Danielskauge/report-project-thesis/Images/results/grid_search_mars_results.png

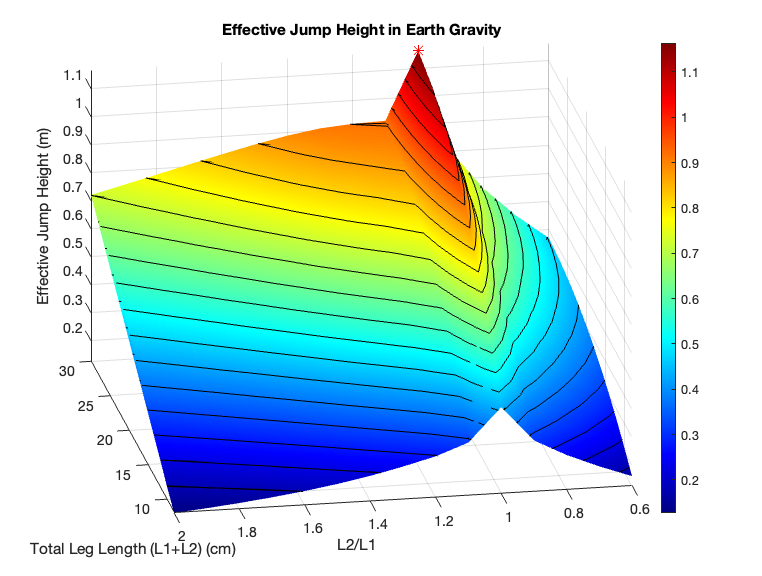
Images/results/grid_search_mars_results.png
