Danielskauge/report-project-thesis/Sections/Abbreviations.tex

\section*{Abbreviations}

\begin{longtable}[l]{p{0.2\textwidth} p{0.75\textwidth}}
    \textbf{Abbreviation} & \textbf{Description} \\
    \hline
    
    \textbf{DRL} & Deep Reinforcement Learning \\
    \textbf{BLDC} & Brushless DC \\
    \textbf{DOF} & Degrees of Freedom \\
    \textbf{CAD} & Computer-Aided Design \\
    \textbf{CNC} & Computer Numerical Control \\
    \textbf{MCU} & Microcontroller Unit \\
    \textbf{MSE} & Mean Squared Error \\
    \textbf{PWM} & Pulse Width Modulation \\
    \textbf{I2C} & Inter-Integrated Circuit \\
    \textbf{ADC} & Analog-to-Digital Converter \\
    \hline
\end{longtable}

\clearpage
