Danielskauge/report-project-thesis/Sections/title.tex

% Inspired by title template from ShareLaTeX Learn; Gubert Farnsworth & John Doe
% Edited by Jon Arnt Kårstad, NTNU IMT

\begin{titlepage}
\vbox{ }
\vbox{ }
\begin{center}
% Upper part of the page
\\[1cm]
\textsc{\LARGE Department of Engineering Cybernetics}\\[1.5cm]
\textsc{\Large TTK4550 - Specialization Project}\\[0.5cm]
\vbox{ }

% Title
\HRule \\[0.4cm]
{ \huge \bfseries Design and Control of a Spring-actuated Jumping Quadruped in Earth Gravity}\\[0.4cm]
\HRule \\[1.5cm]

% Author
\large
\emph{Author:}\\
Johannes Ihle\\
Daniel Rosmæl Skauge\\
\vspace{1em}
\emph{Supervisor:}\\
Prof. Dr. Kostas Alexis\\
\vspace{1em}
\emph{Co-supervisor:}\\
Jørgen Anker Olsen
\vfill

% Bottom of the page
{\large Date: \today}
\end{center}
\end{titlepage}
