Danielskauge/report-project-thesis/Sections/Design.pdf

??????θ1 =

−

(θ2+π)
2
˙θ2 =
−2

˙θ1
??θ2
????????

manipulator.pngT hemanipulatorcorrespondingtoaverticalonelegjump.

xend = L1 cos(θ1)+L2 cos(θ1+θ2)yend = L1 sin(θ1)+L2 sin(θ1+θ2)
(1)
1 sin(θ1)−
L2 sin(θ1+
θ2)−
L2 sin(θ1+
θ2)
L1 cos(θ1)+
L2 cos(θ1+
θ2)L2 cos(θ1+
θ2)
jacobianvelocity.epsV erticalP awvelocityasafunctionof kneeangle.
????????

## Robot Jumping Controller Logic

Friction Scaling:
Nµ ← 0.8 Nµ

Angle Conversions (Degrees to Radians):

θ1 =

π
180
θhip deg, | θ2 = π
| 180 θknee deg

w1 =

π
180
whip deg, | w2 = π
| 180 wknee deg

Link Lengths:
l1 = thigh l m, l2 = calf l m

Capping Angular Velocities:

w1,abs = min(|w1|, whip max), w2,abs = min(|w2|, wknee max)

Maximum Torque Based on Speed:

τ1,max abs = τhip stall
1 −
| w1,abs

whip max

τ2,max abs = τknee stall
1 −

w2,abs

wknee max

Assigning Torques:

τ2 = τ2,max abs, τ1,motor dyn limit = −τ1,max abs

Friction Cone Constraint:

τ1,friction cone limit =

− l1 l2 sin(θ2) Nµ +

l1 sin(θ1) + l2 sin(θ1 + θ2)
τ2
l2 sin(θ1 + θ2)

Final Hip Torque Selection:

τ1 = max

τ1,motor dyn limit, τ1,friction cone limit

Direction-Dependent Torque Output:

τhip = (front1 backneg1) τ1, τknee = (front1 backneg1) τ2

2
