Danielskauge/report-project-thesis/Images/vertical_paw_velocity-eps-converted-to.pdf

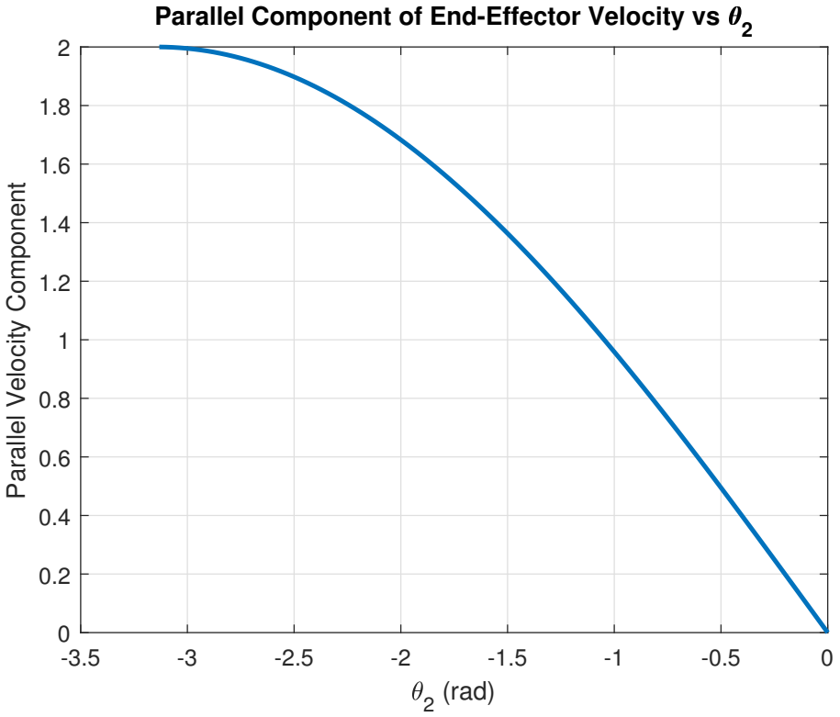
[picture p34: figure]
(rad); Parallel Velocity Component

Parallel Component of End-Effector Velocity vs 2
