Danielskauge/report-project-thesis/Images/horizontal_jacobian_velocity-eps-converted-to.pdf

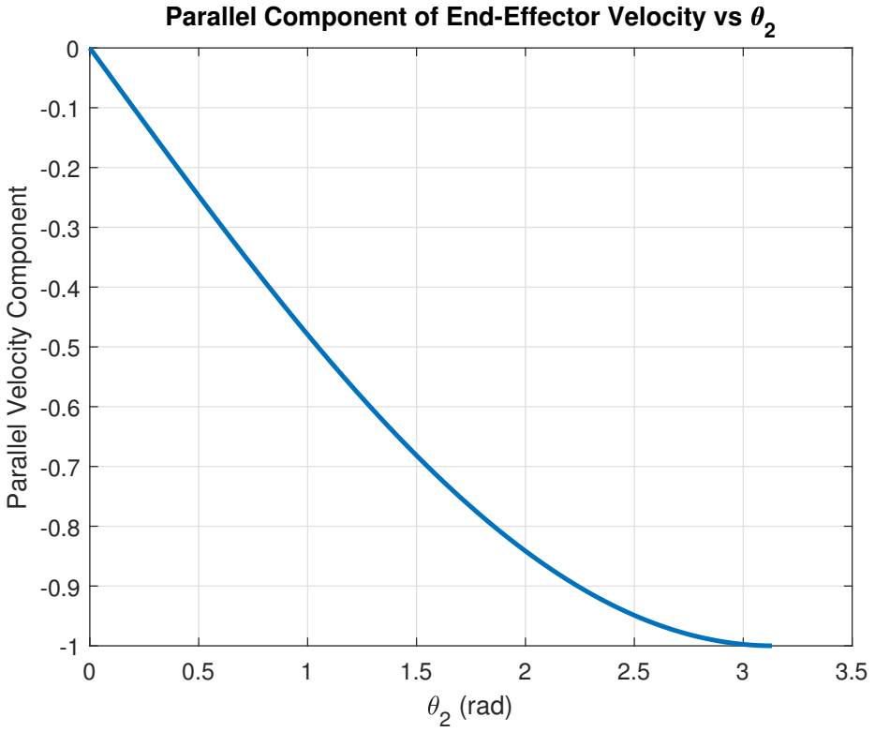
[picture p35: figure]
(rad); Parallel Velocity Component

Parallel Component of End-Effector Velocity vs 2
