Danielskauge/report-project-thesis/Images/joint_speed_A80-eps-converted-to.pdf

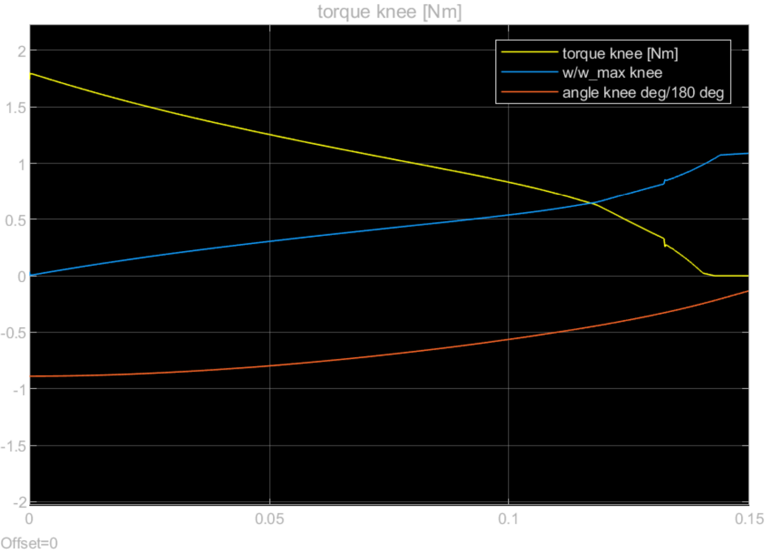
[picture p36: page 1]
