Danielskauge/report-project-thesis/Images/hip_motor_torque-eps-converted-to.pdf

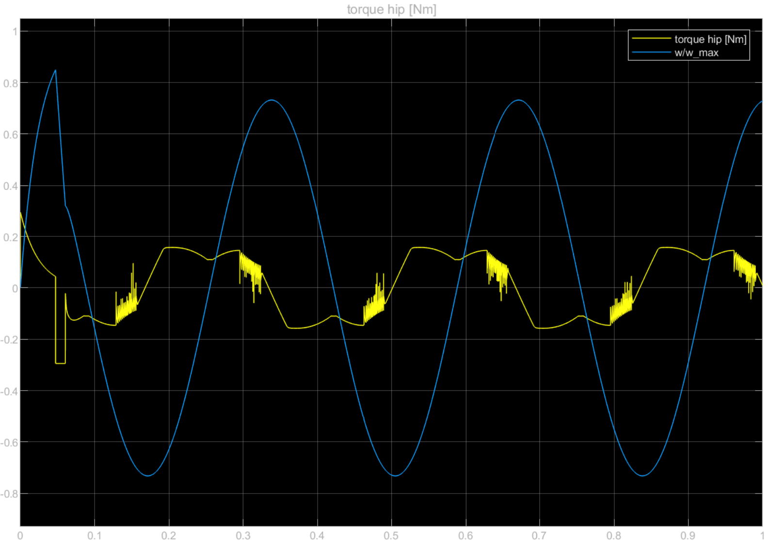
[picture p37: page 1]
