Danielskauge/report-project-thesis/Images/A06_motor_info.jpg

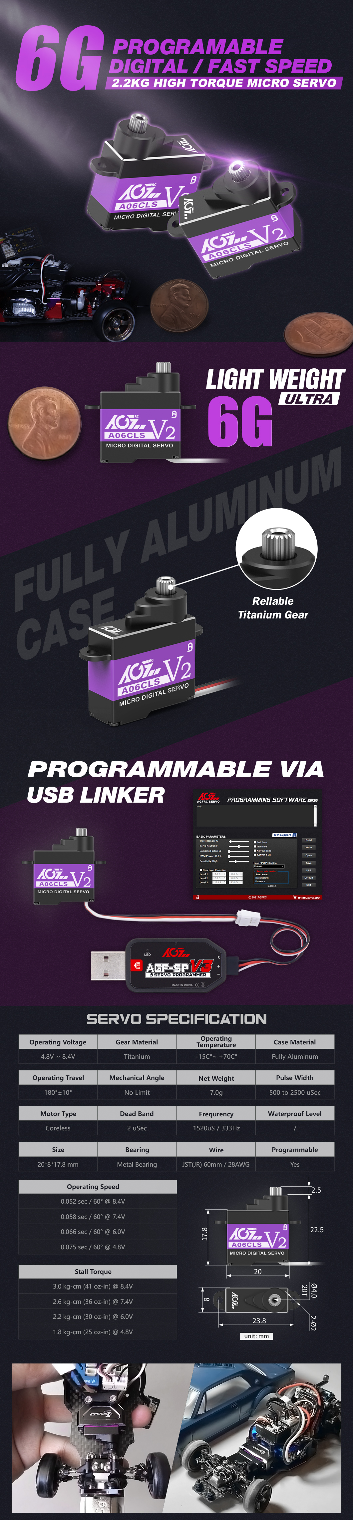
Images/A06_motor_info.jpg
