Danielskauge/report-project-thesis/Images/angle_conventions.png

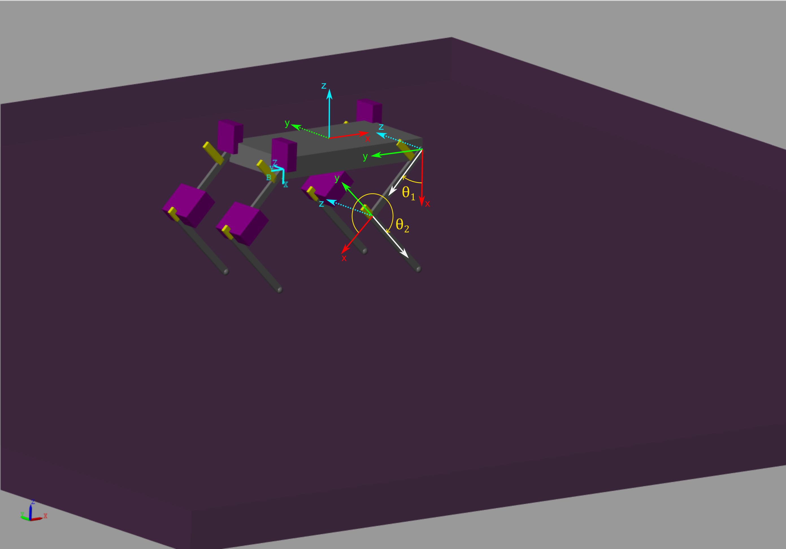
Images/angle_conventions.png
