Danielskauge/report-project-thesis/Images/attituding_hips.png

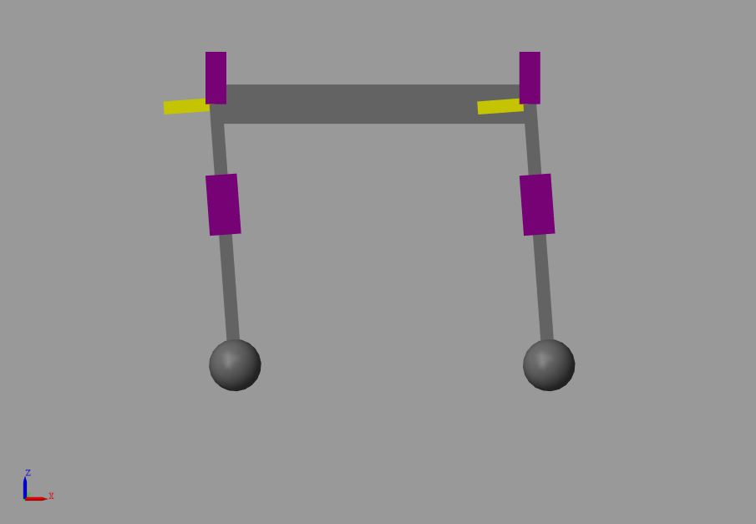
Images/attituding_hips.png
