Danielskauge/report-project-thesis/Images/CAD_leg_exploded_annotate.png

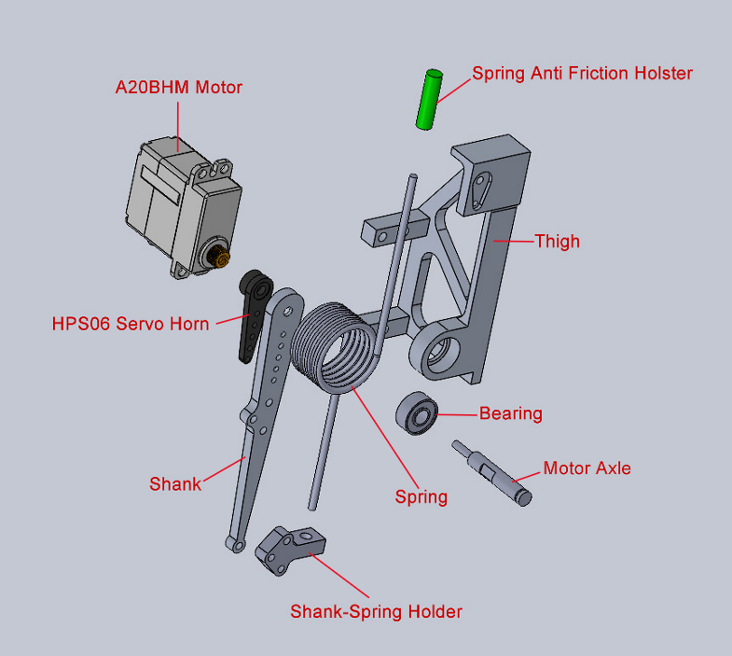
Images/CAD_leg_exploded_annotate.png
