Danielskauge/report-project-thesis/Images/crouched_simscape_robot.png

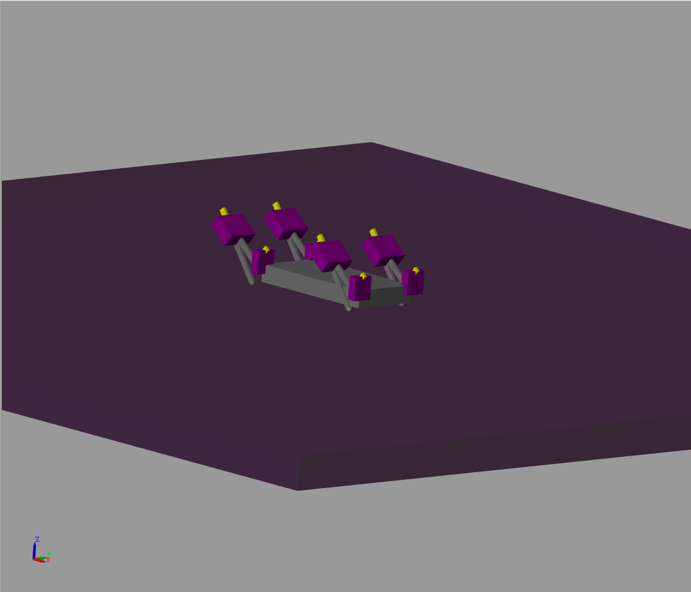
Images/crouched_simscape_robot.png
