Danielskauge/report-project-thesis/Images/DOF2_w_extension_spring.png

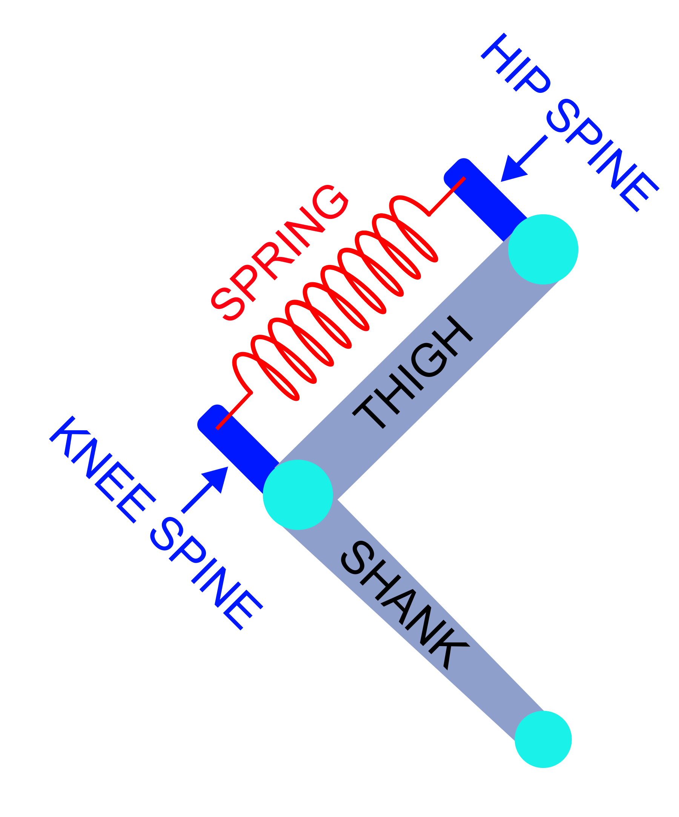
Images/DOF2_w_extension_spring.png
