Danielskauge/report-project-thesis/Images/exploded_motor_holder_hip.png

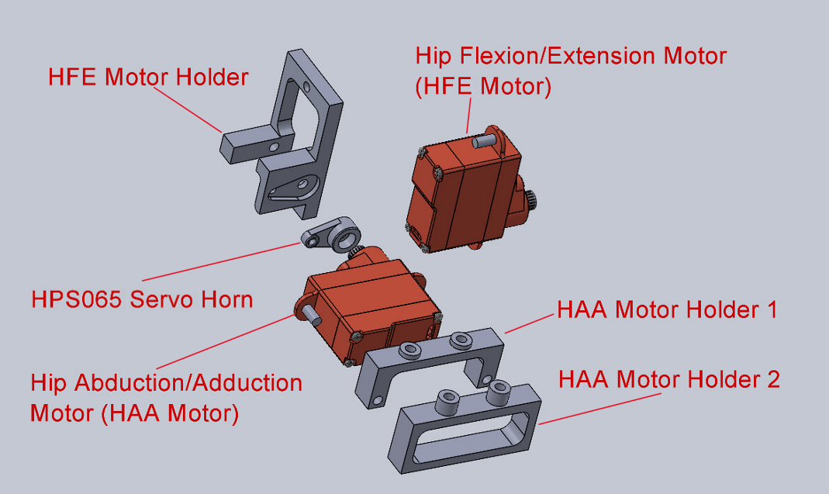
Images/exploded_motor_holder_hip.png
