Danielskauge/report-project-thesis/Images/extension_spring.png

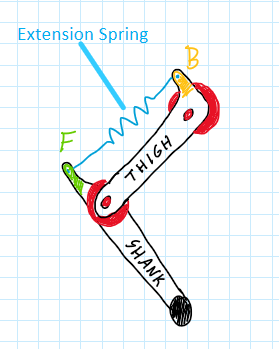
Images/extension_spring.png
