Danielskauge/report-project-thesis/Images/friction_estimation/big_motor.jpg

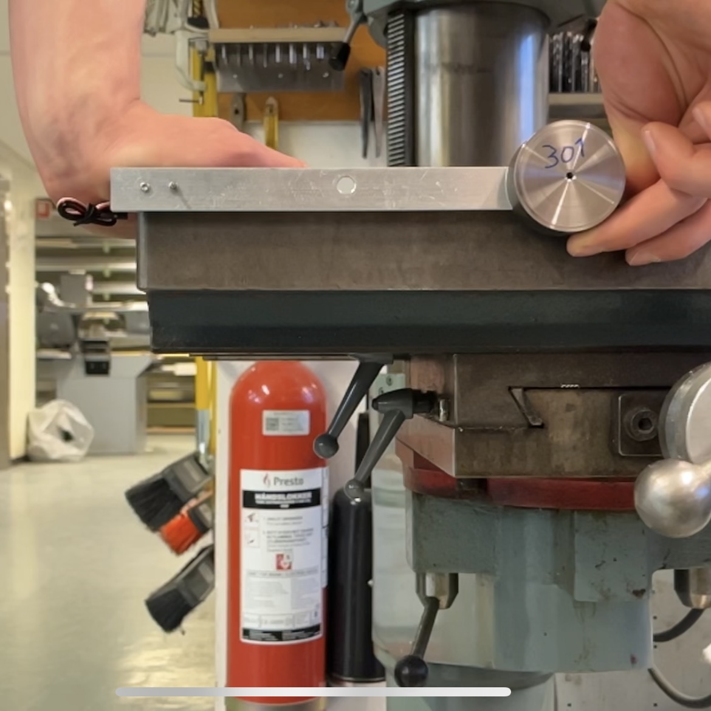
Images/friction_estimation/big_motor.jpg
