Danielskauge/report-project-thesis/Images/friction_estimation/pendulum_sim_hip.png

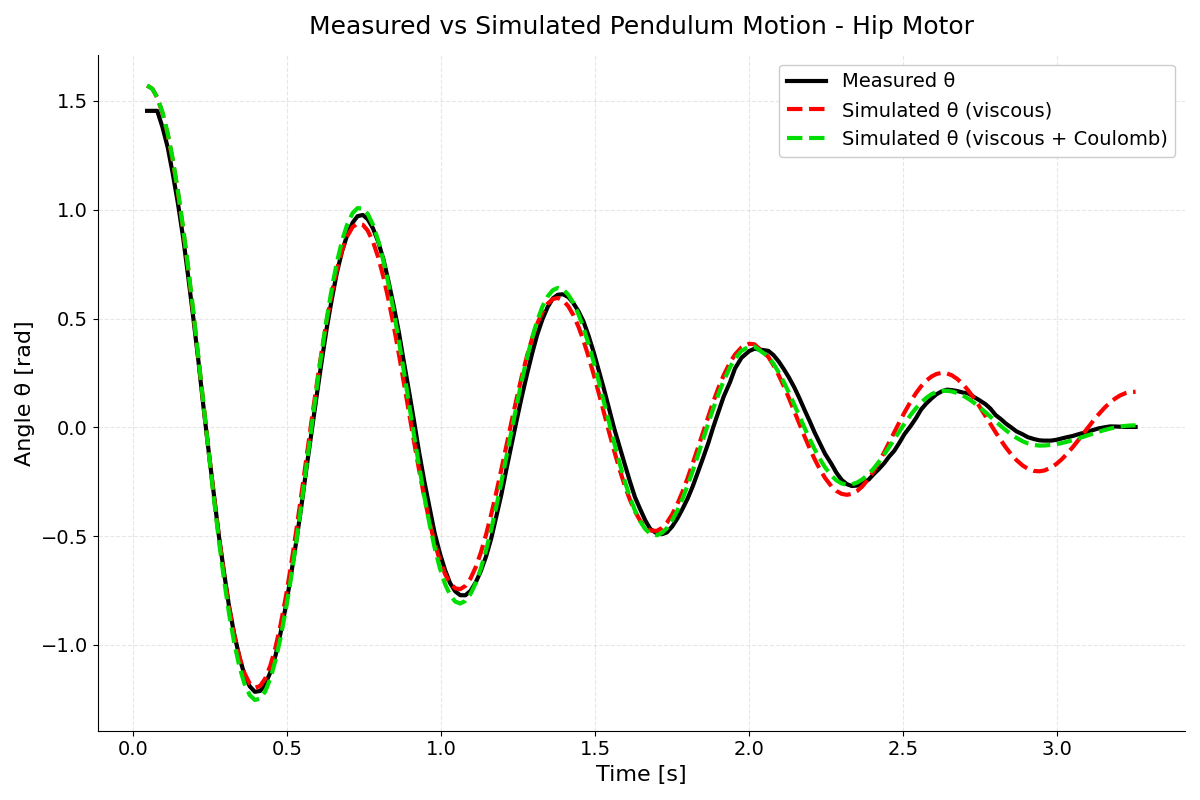
Images/friction_estimation/pendulum_sim_hip.png
