Danielskauge/report-project-thesis/Images/friction_estimation/pendulum_sim_knee.png

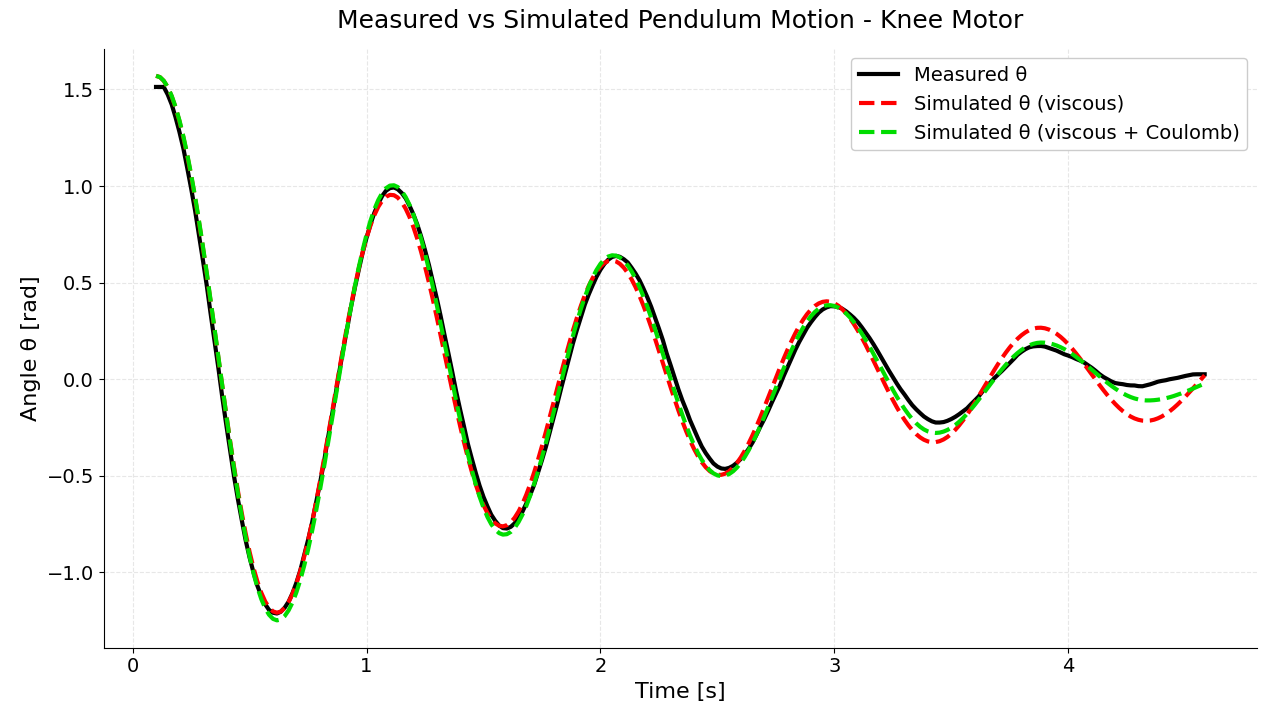
Images/friction_estimation/pendulum_sim_knee.png
