Danielskauge/report-project-thesis/Images/friction_estimation/small_motor.jpg

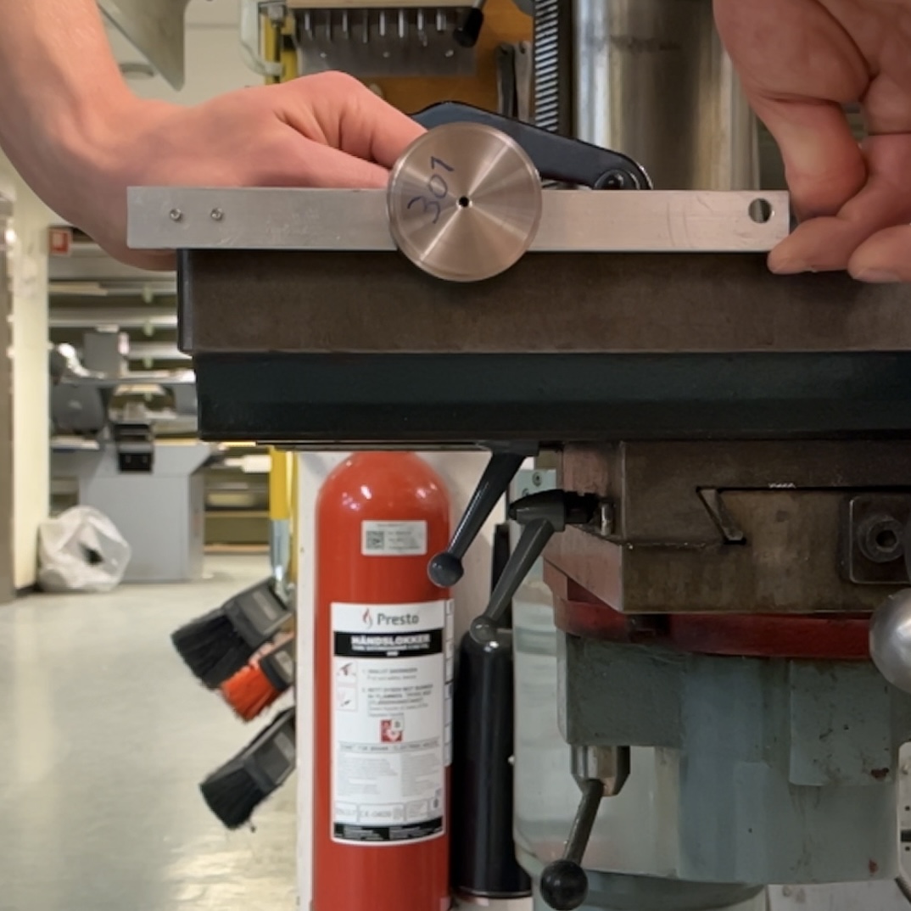
Images/friction_estimation/small_motor.jpg
