Danielskauge/report-project-thesis/Images/hip_motor_in_housing.JPG

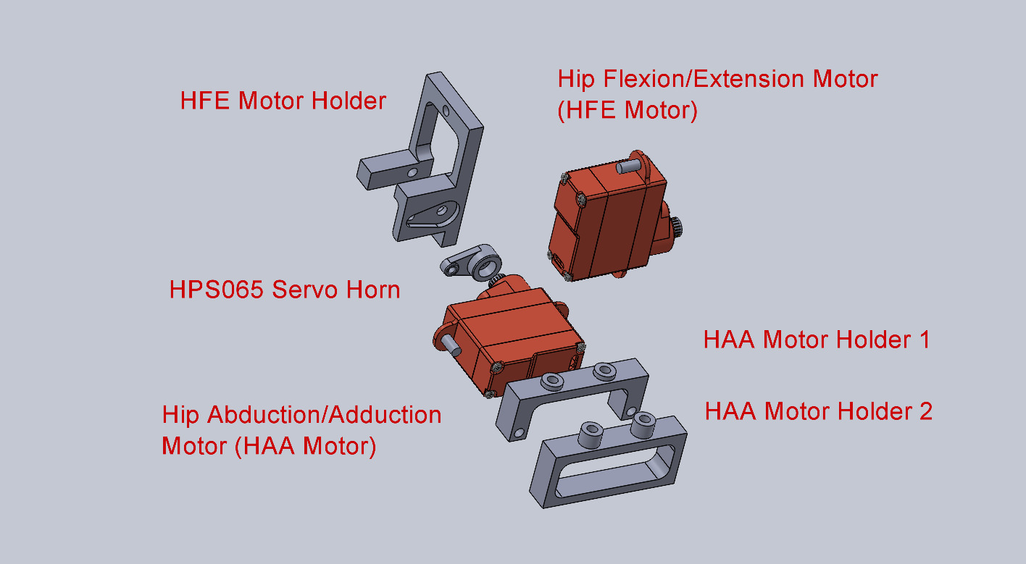
Images/hip_motor_in_housing.JPG
