Danielskauge/report-project-thesis/Images/legv3_annotated.SLDASM.JPG

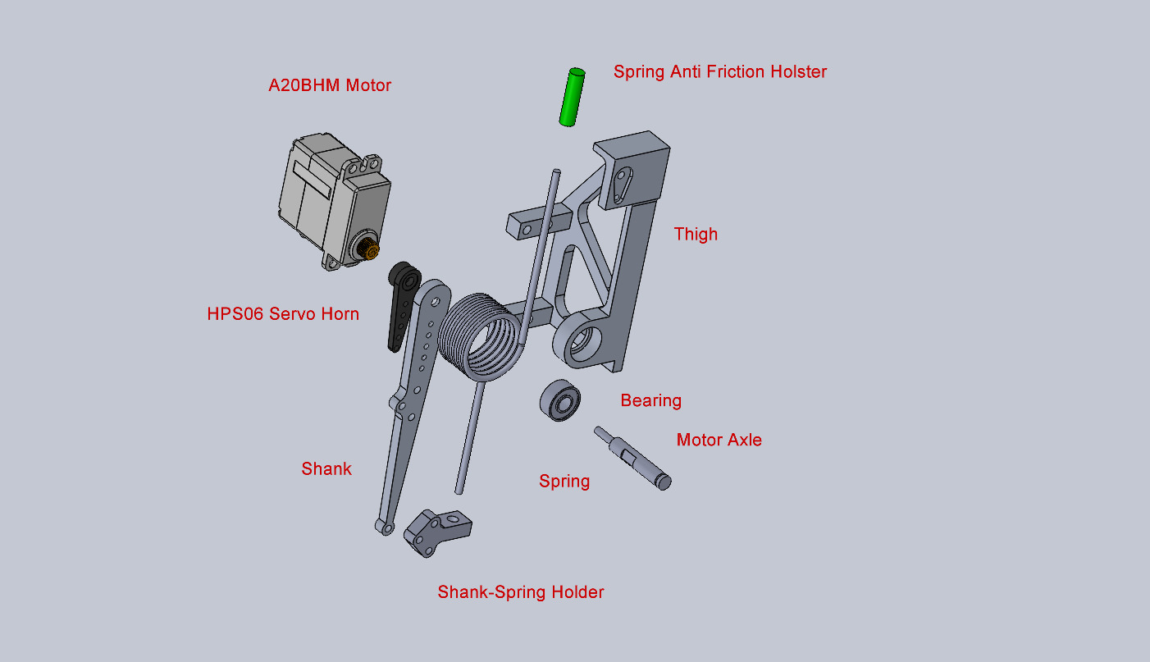
Images/legv3_annotated.SLDASM.JPG
