Danielskauge/report-project-thesis/Images/legv3_exploeded.JPG

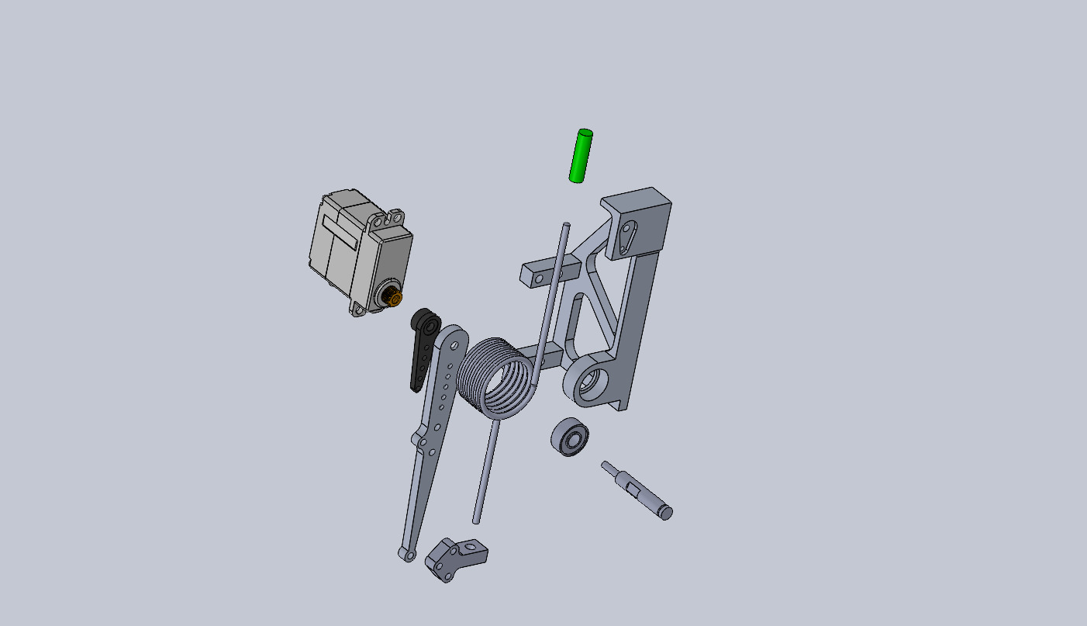
Images/legv3_exploeded.JPG
