Danielskauge/report-project-thesis/Images/link_length_optimization/adjusted_paw_pose.png

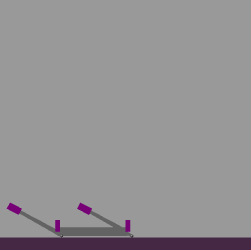
Images/link_length_optimization/adjusted_paw_pose.png
