Danielskauge/report-project-thesis/Images/link_length_optimization/longer_L1_pose.png

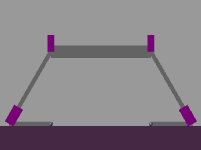
Images/link_length_optimization/longer_L1_pose.png
