Danielskauge/report-project-thesis/Images/link_length_optimization/symmetric_unadjusted_paws.png

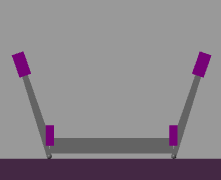
Images/link_length_optimization/symmetric_unadjusted_paws.png
