Danielskauge/report-project-thesis/Images/manipulator_inkscape.png

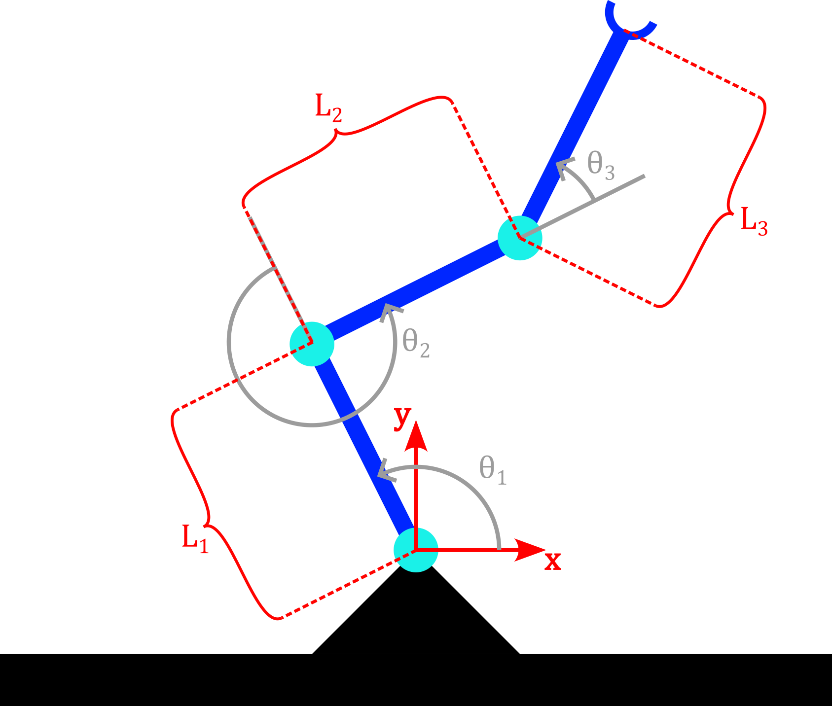
Images/manipulator_inkscape.png
