Danielskauge/report-project-thesis/Images/motor_model_function.png

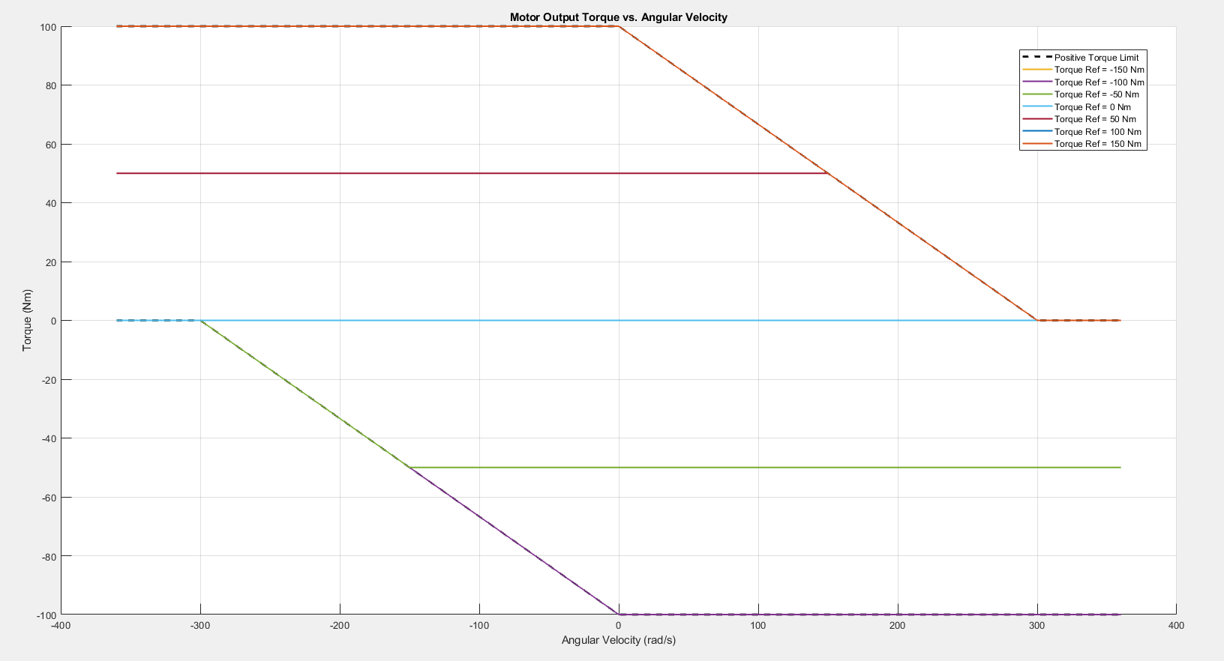
Images/motor_model_function.png
