Danielskauge/report-project-thesis/Images/naming_conventions.png

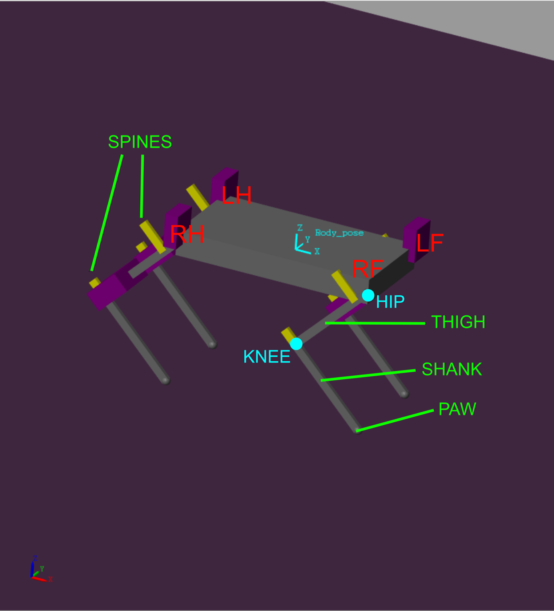
Images/naming_conventions.png
