Danielskauge/report-project-thesis/Images/one_axis_jump.png

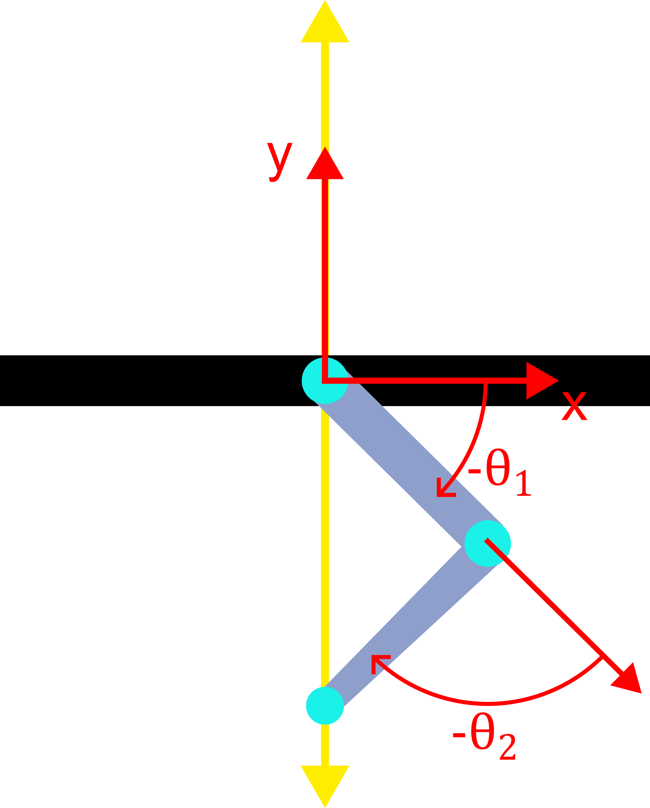
Images/one_axis_jump.png
