Danielskauge/report-project-thesis/Images/parallell_spring_inkscape.png

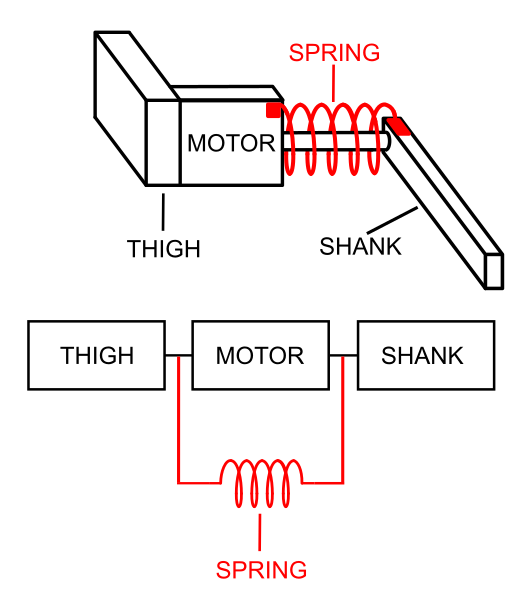
Images/parallell_spring_inkscape.png
