Danielskauge/report-project-thesis/Images/Screenshot 2024-12-17 at 19.40.37.png

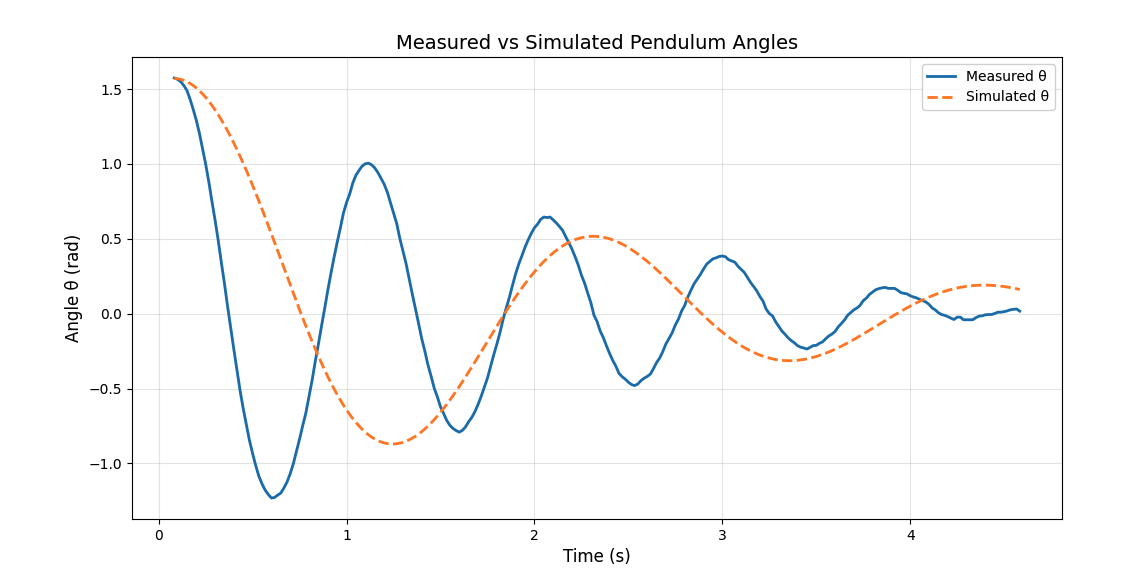
Images/Screenshot 2024-12-17 at 19.40.37.png
