Danielskauge/report-project-thesis/Images/series_elastic_inkscape.png

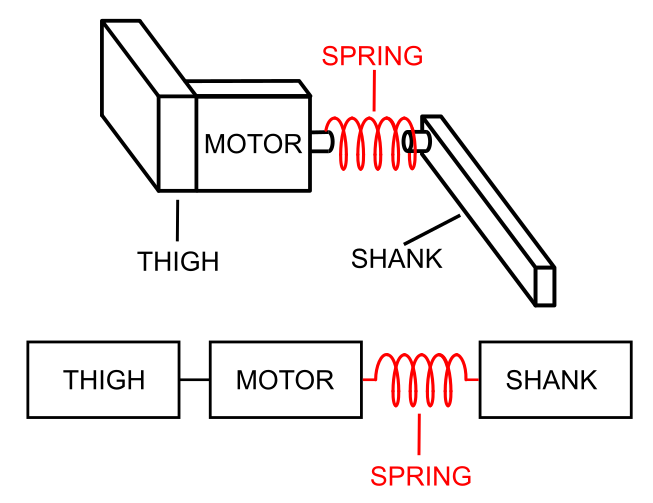
Images/series_elastic_inkscape.png
