Danielskauge/report-project-thesis/Images/simcape_extension_spring.png

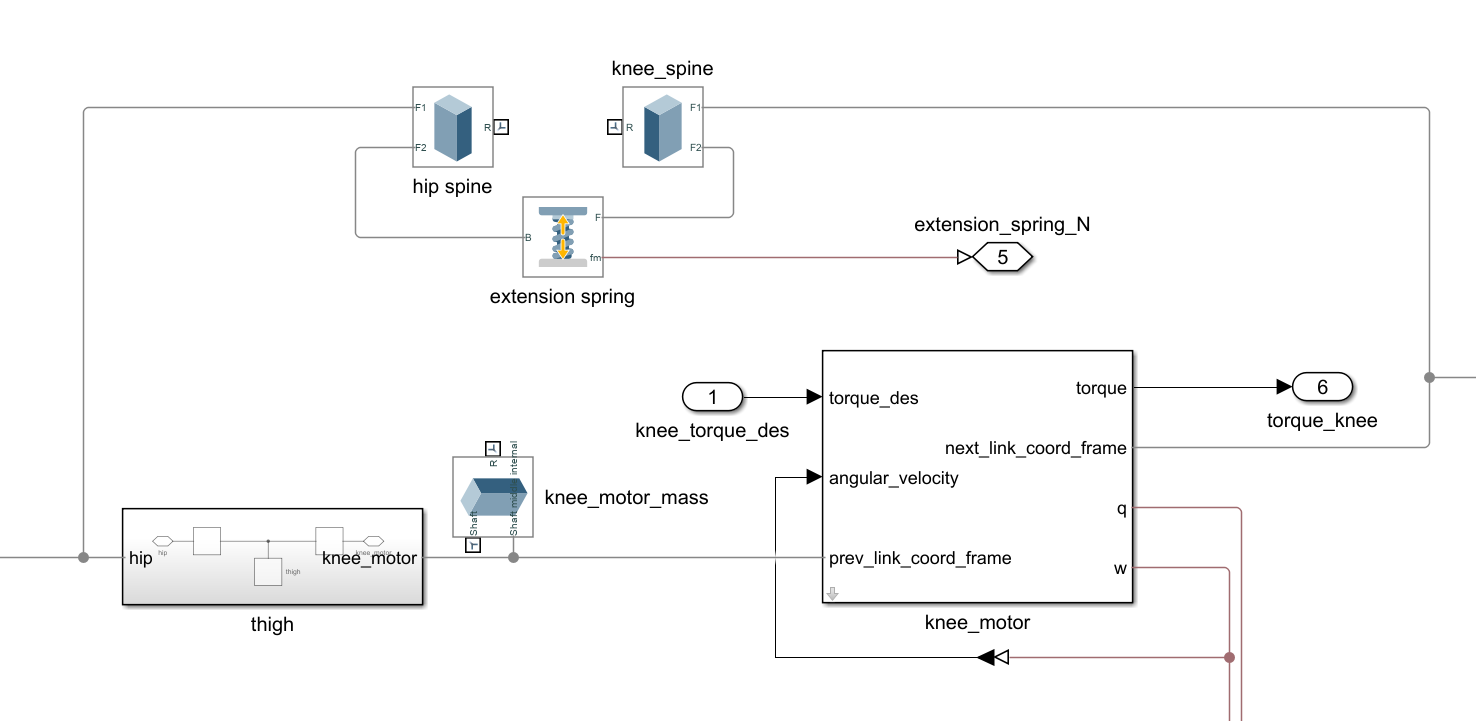
Images/simcape_extension_spring.png
