Danielskauge/report-project-thesis/Images/simscape_extension_spring.png

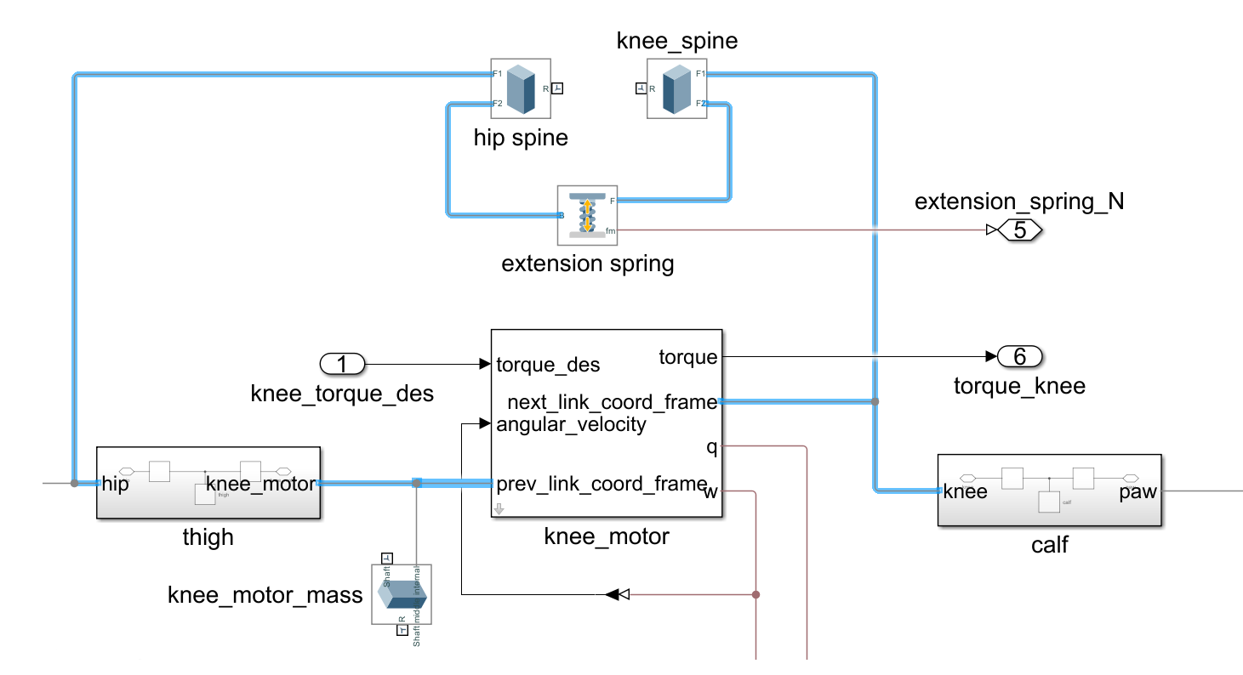
Images/simscape_extension_spring.png
