Danielskauge/report-project-thesis/Images/simscape_motor.png

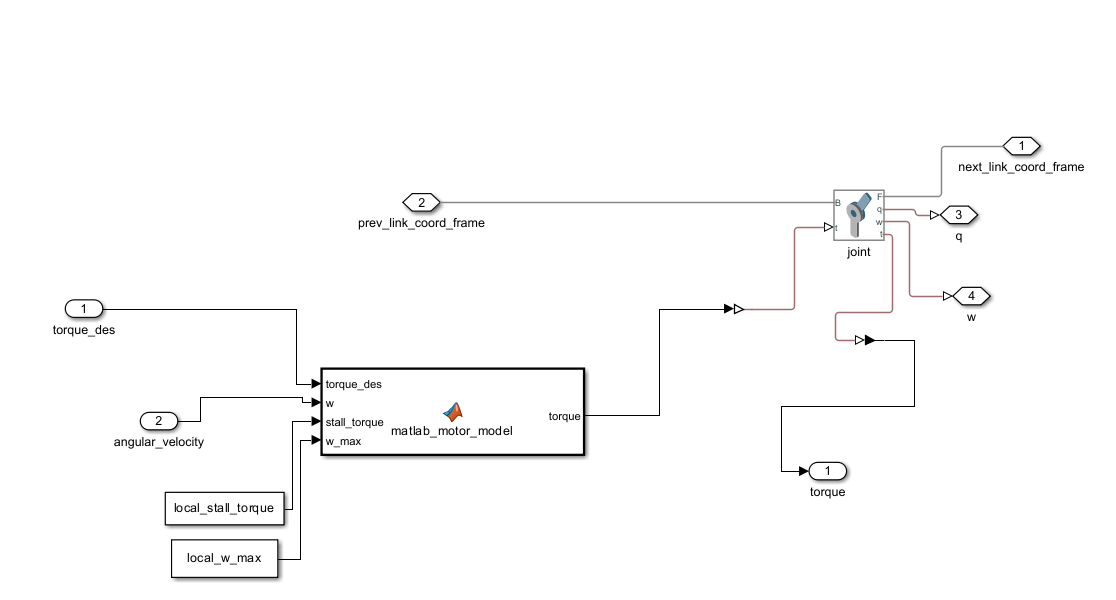
Images/simscape_motor.png
