Danielskauge/report-project-thesis/Images/torque_speed_own.png

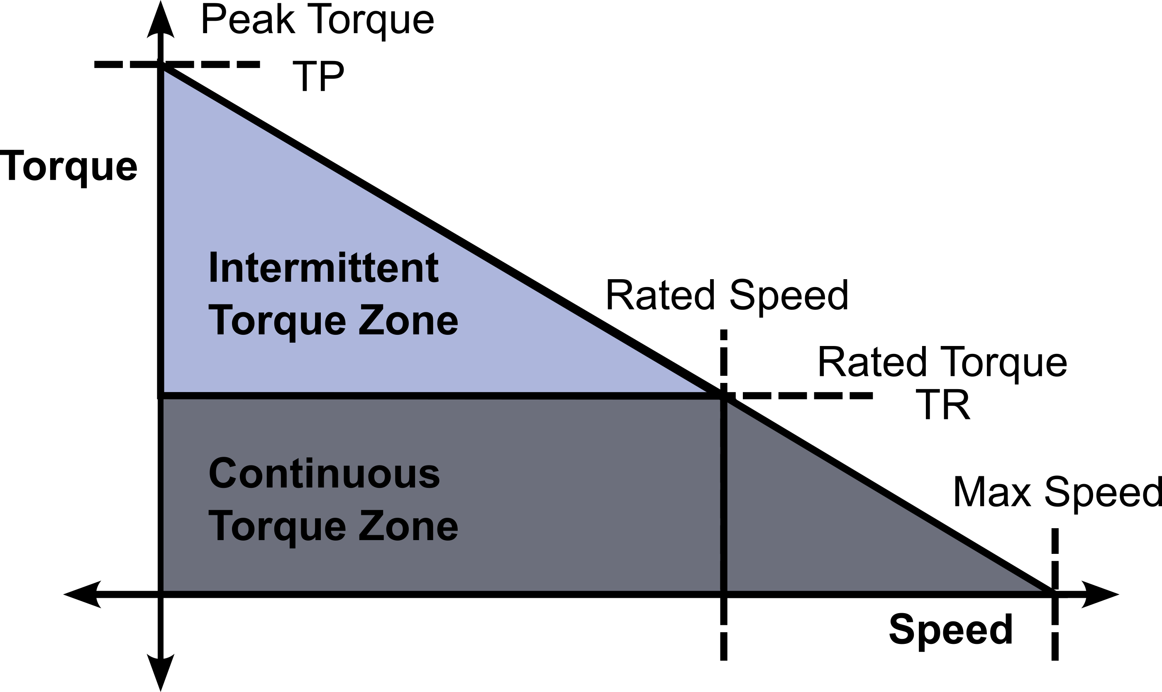
Images/torque_speed_own.png
