Danielskauge/report-project-thesis/Images/legv3_annotated.SLDASM

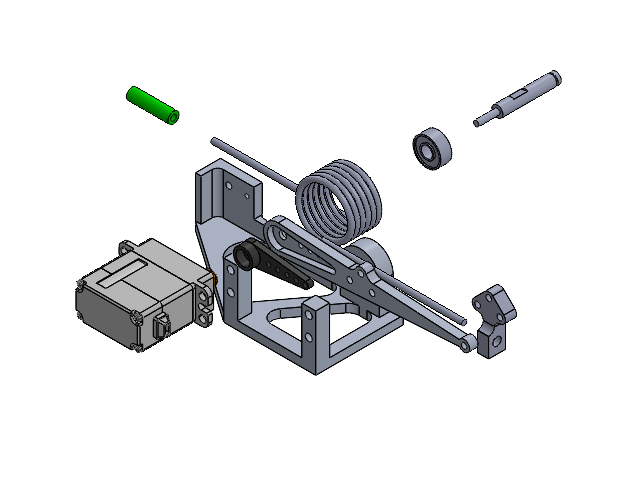
[picture p71: CAD file, 2024-12-17]
Images/legv3_annotated.SLDASM
thigh_v3
DDJ-9GCNC-M.stp
DDJ-9GCNC-MOTOR.stp
DDJ-9GCNC-ZHOUCHENG2.stp
DDJ-9GCNC-GEAR5.stp
DDJ-9GCNC-T.stp
DDJ-9GCNC-B.stp
DDJ-9GCNC-XT.stp
DDJ-9GCNC-LS.stp x 4
bearing_simplified_ID_4mm_OD_10mm
HPS06_simplified
Sodemann T075-180-484R_copy_open
shank_v3
shank_spring_holder
plastic_spring_lube_holster
kne_aksling
