Danielskauge/report-project-thesis/Images/manufacture_only.png

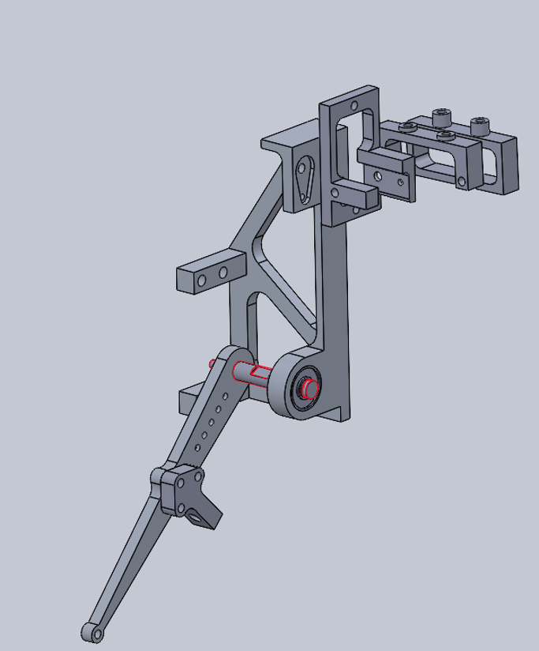
Images/manufacture_only.png
