Danielskauge/report-project-thesis/Images/matlab_tutorial_svg.png

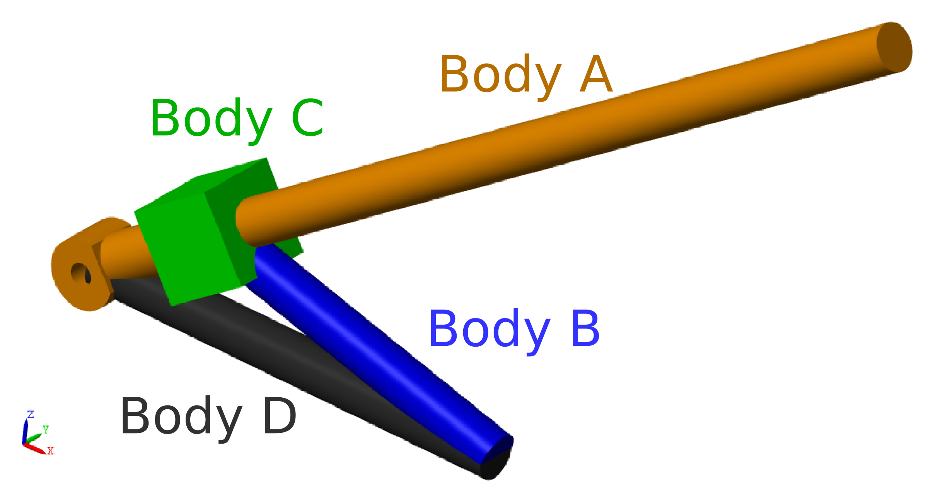
Images/matlab_tutorial_svg.png
