Danielskauge/report-project-thesis/Images/printed_leg_and_spring.jpg

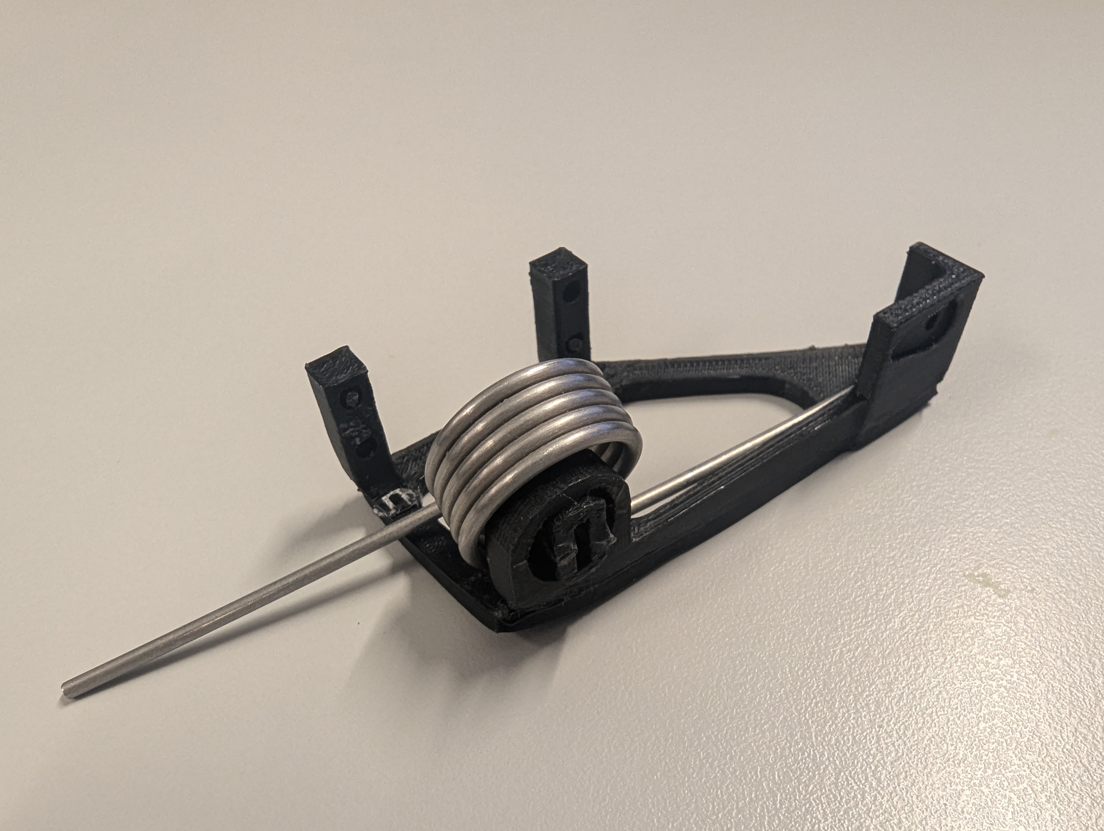
Images/printed_leg_and_spring.jpg
