Danielskauge/report-project-thesis/Images/simscape_tutorial_diagram2.png

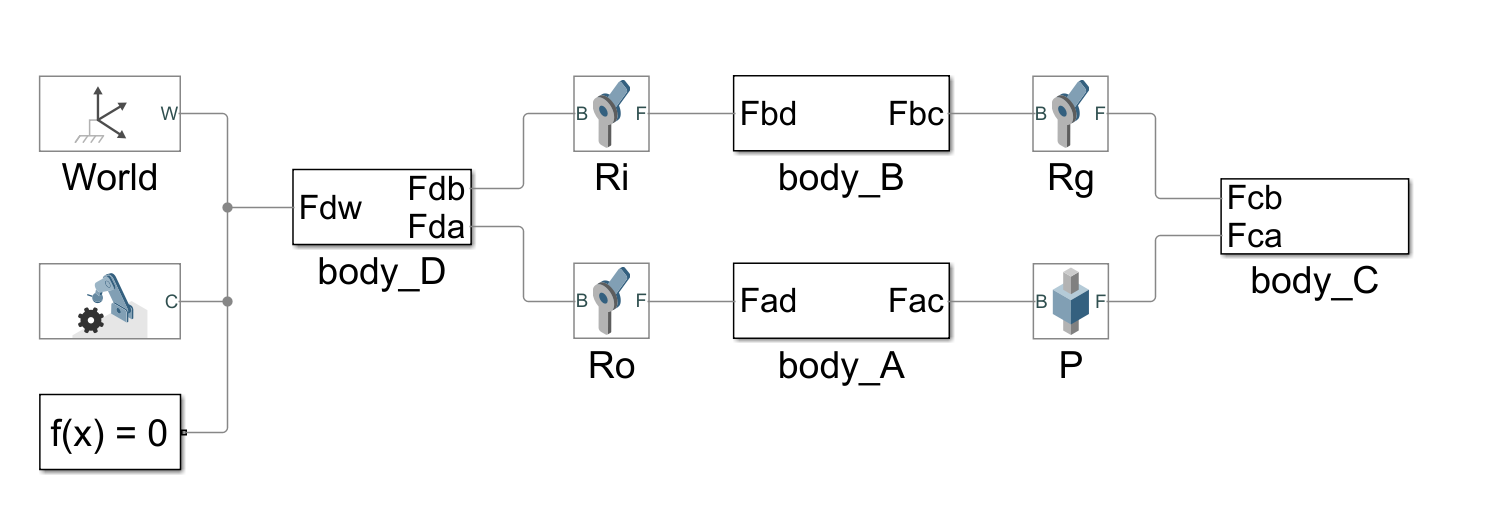
Images/simscape_tutorial_diagram2.png
