Danielskauge/report-project-thesis/Images/attitude_stable_test_result-eps-converted-to.pdf

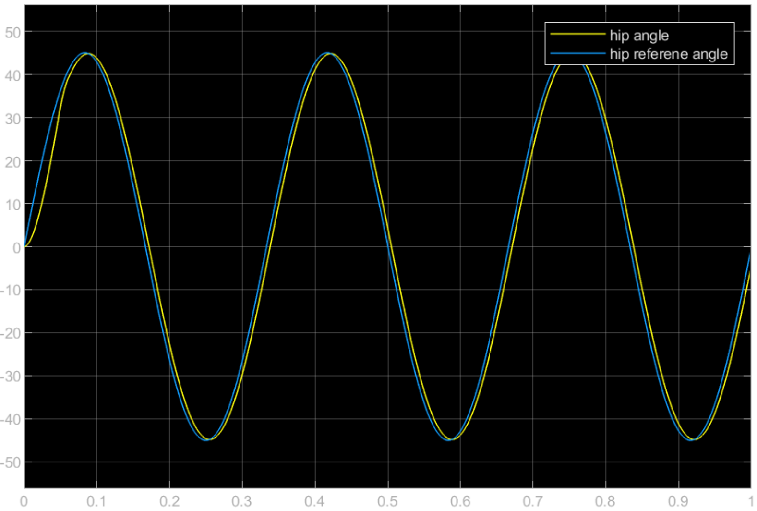
[picture p76: page 1]
