Danielskauge/report-project-thesis/Images/paw_swing_test.png

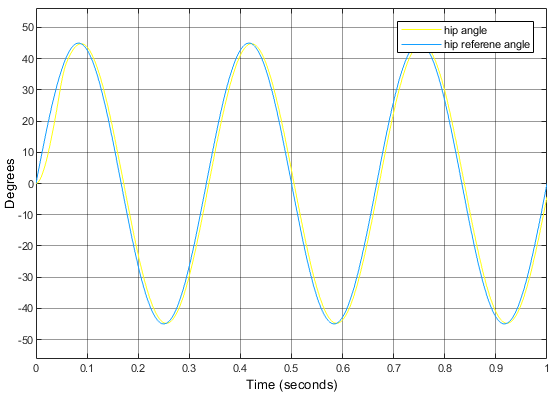
Images/paw_swing_test.png
