Danielskauge/report-project-thesis/Images/results/grid_search_earth.png

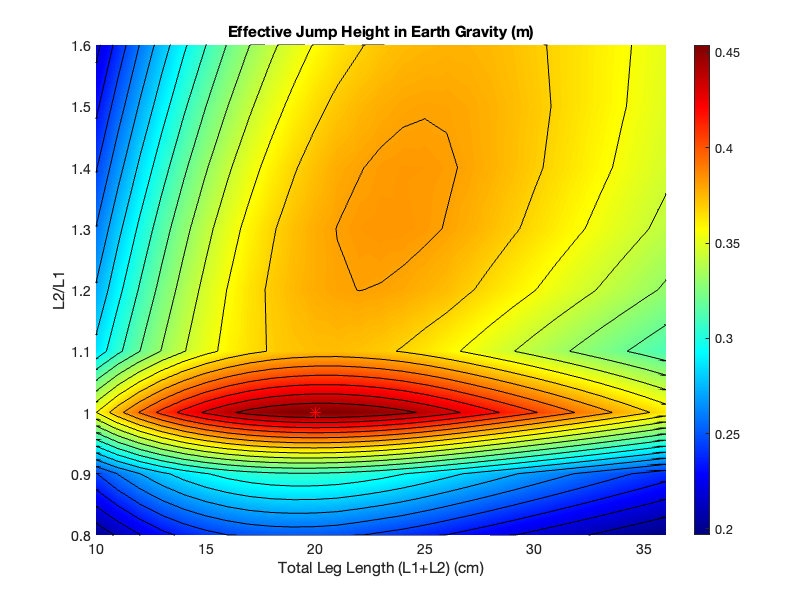
Images/results/grid_search_earth.png
