Danielskauge/report-project-thesis/Images/results/grid_search_forward_mars.png

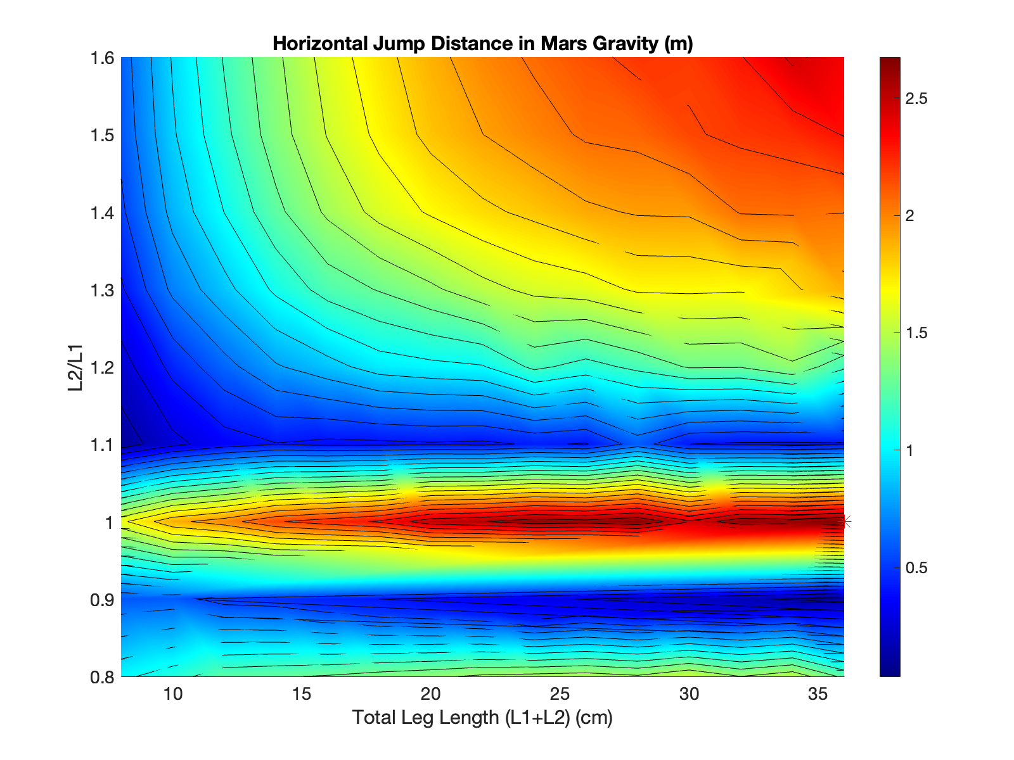
Images/results/grid_search_forward_mars.png
