Danielskauge/report-project-thesis/Images/results/grid_search_mars.png

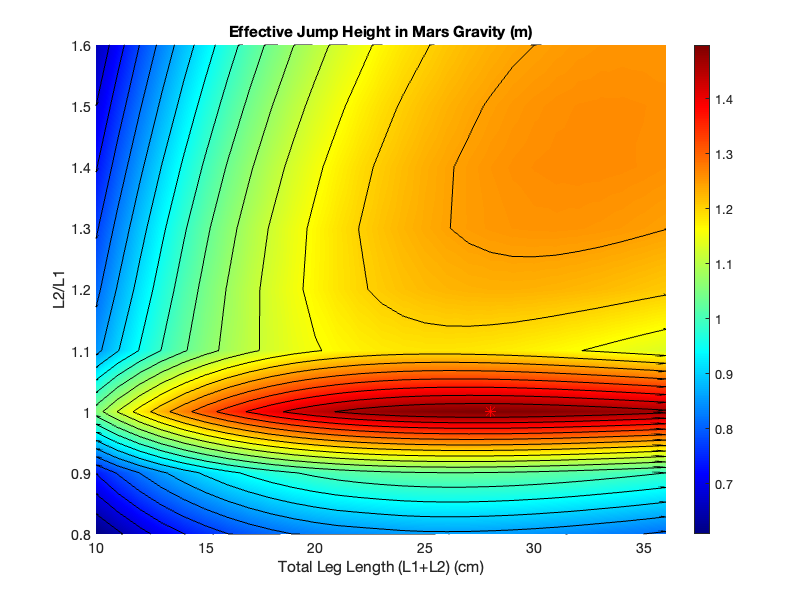
Images/results/grid_search_mars.png
