Danielskauge/report-project-thesis/Images/results/grid_search_results.png

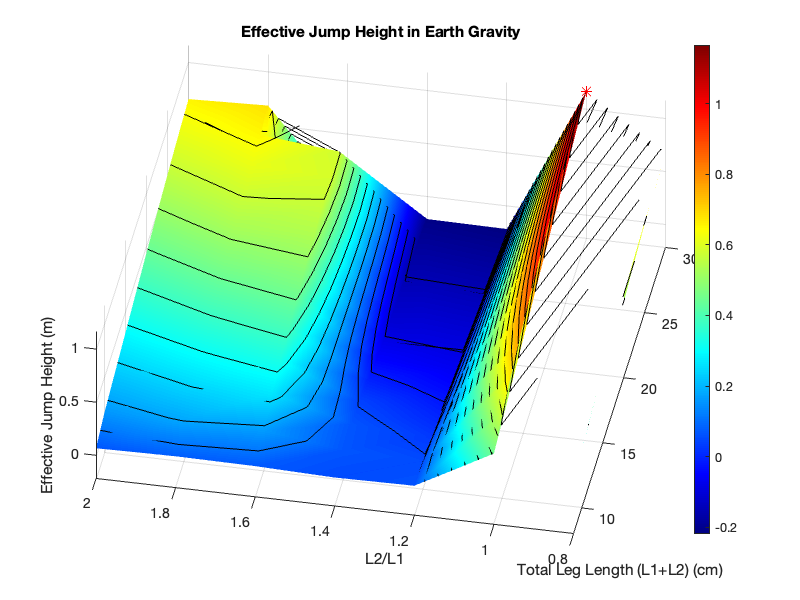
Images/results/grid_search_results.png
