Danielskauge/report-project-thesis/Images/results/grid_search_results_mars_flat.png

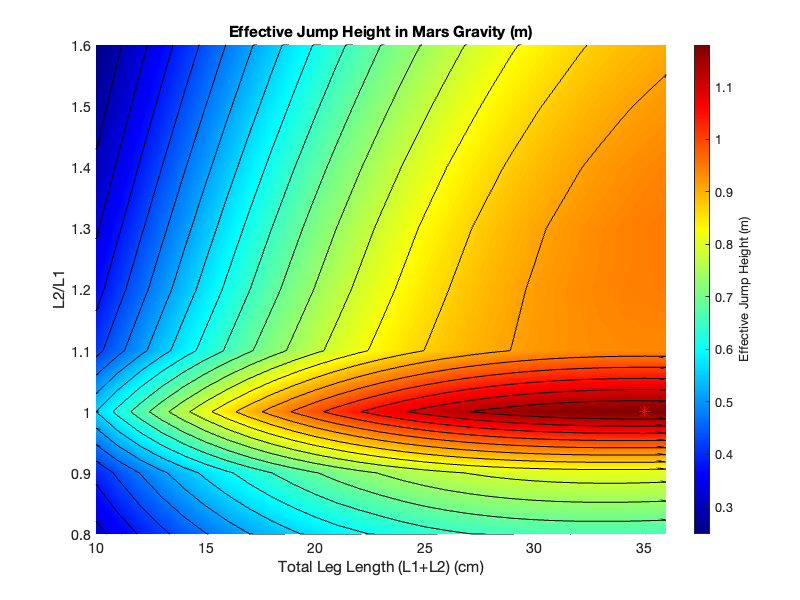
Images/results/grid_search_results_mars_flat.png
