Danielskauge/report-project-thesis/PDF/A06_motor_info_website_pdf.pdf

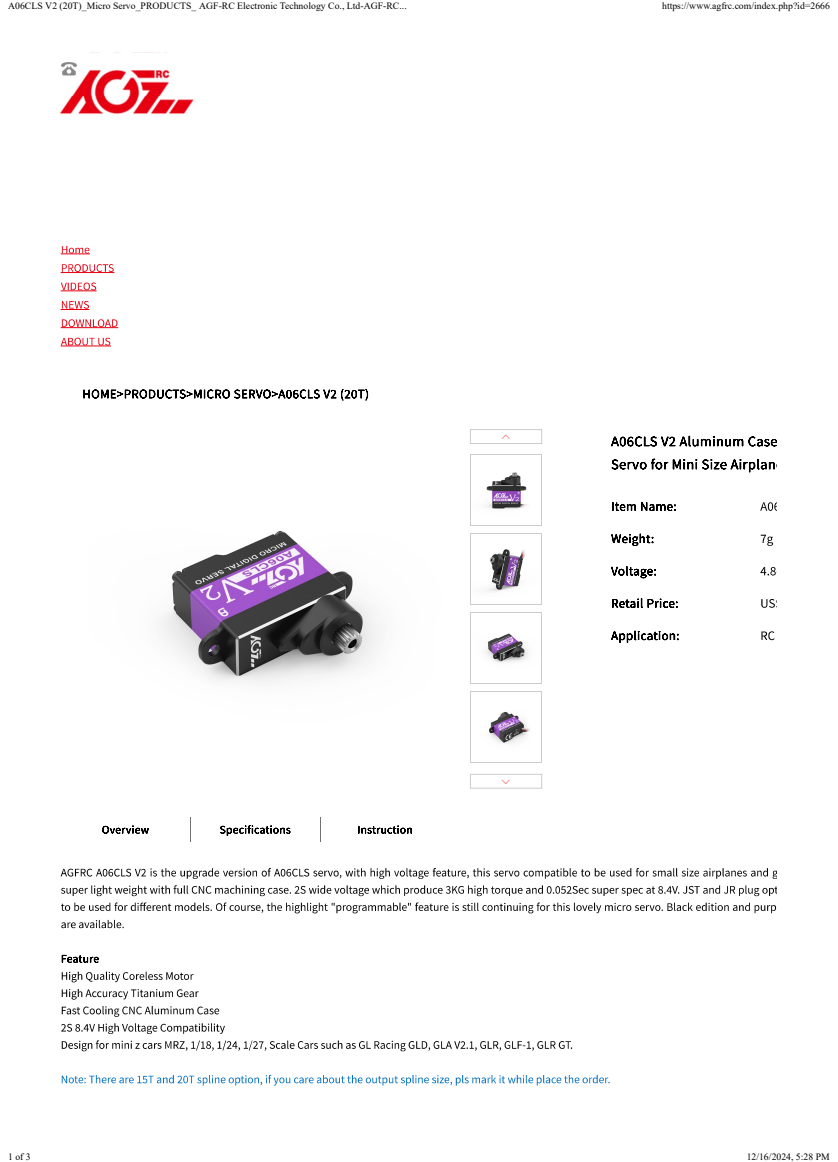
[picture p84: page 1]
A06CLS V2 (20T)_Micro Servo_PRODUCTS_ AGF-RC Electronic Technology Co., Ltd-AGF-RC...; https://www.agfrc.com/index.php?id=2666

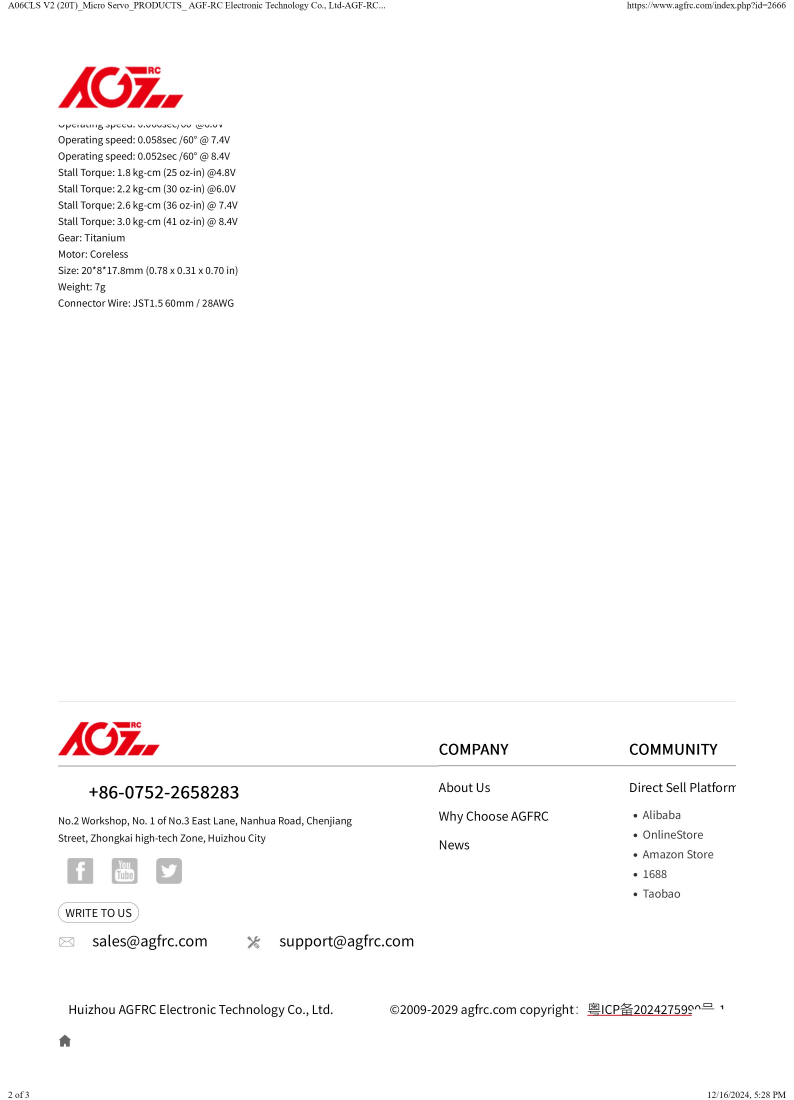
[picture p85: page 2]
