Danielskauge/report-project-thesis/Images/vertical_jacobian_velocity-eps-converted-to.pdf

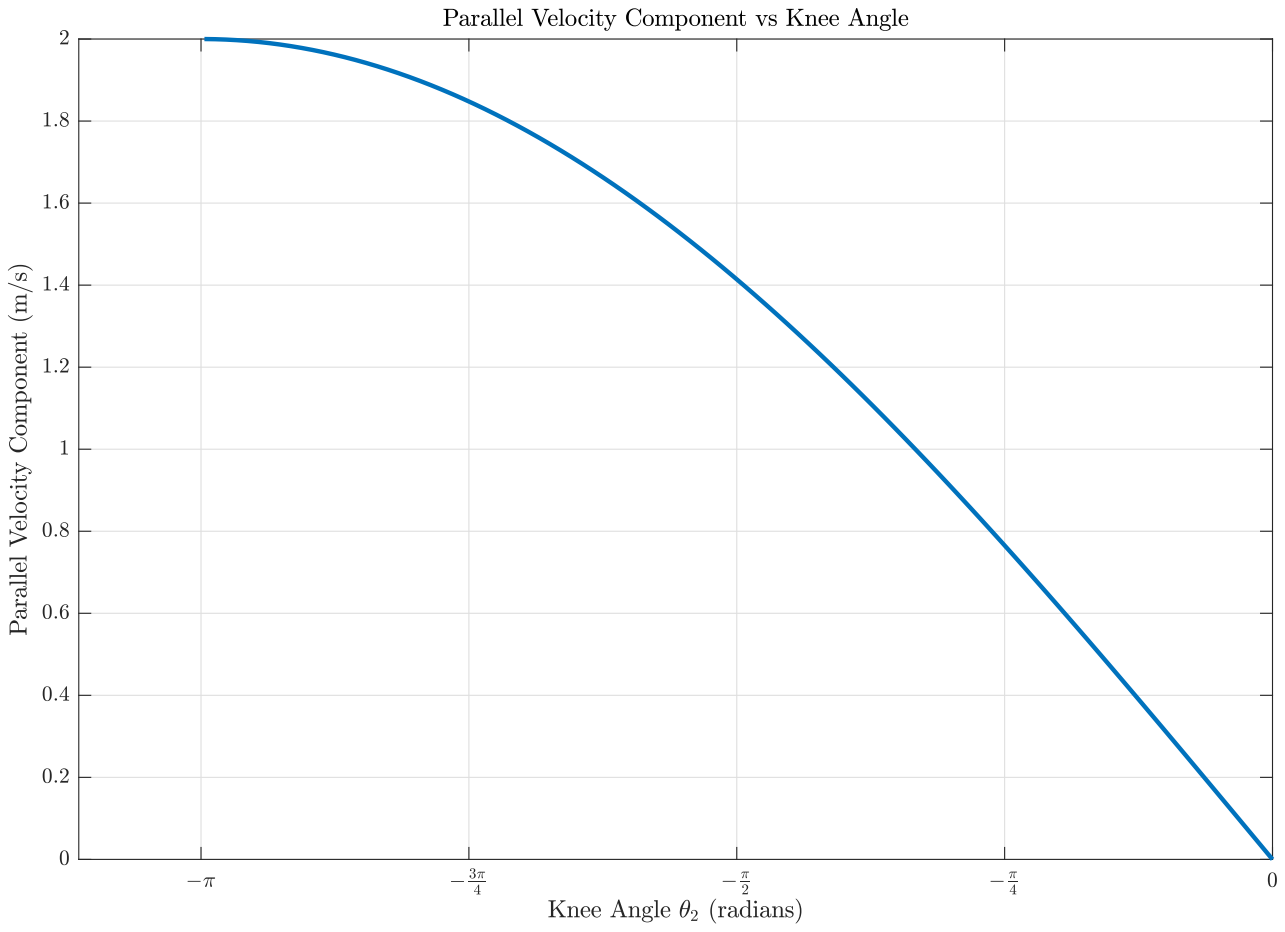
[picture p86: page 1]
