Danielskauge/report-project-thesis/(commit log)

2024-12-14 More motor theory, simscape image conventions
2024-12-15 update motor fricition est
2024-12-15 update link length optimization and motor friction estimation
2024-12-15 add linear regression and inverse kinematics theory
2024-12-16 Switched nonexistent figure to random placeholder, everything now compiles without error
2024-12-17 Motor only results
2024-12-17 bldc_theory label
2024-12-17 inverse kinematrics update
2024-12-17 Added new CAD graphics, also other changes
    [legv3_annotated.SLDASM]
2024-12-18 motor friction update
2024-12-18 add linreg, finite differences, moving average filter, and inertia theory sections
